paper-tei/smart_car/README.md

# 欢迎

本项目下的.md文件推荐用typora打开，文件已添加至仓库根目录处,文档正在编写中

更新日志：

1.完成了基本的文件分类索引 _2023.12.20

2.完成了平衡控制概述 _2023.12.22

3.完成了动量轮部分代码解析 _2024.1.2

4.规则更新,独轮组彻底成为历史,谢谢大家,江湖很大有缘再会 _2024.11.4

5.孩子们,我回来了 _2024.11.5
