paper-tei/smart_car/swjtu_-smart-car_23/README.md

# 欢迎

## 介绍
    西南交通大学 2023年 大学生智能汽车竞赛 独轮车组 “听党指挥，独轮不倒”队 开源项目

## 目录
1. 22_SWJTU_SmartCar-master 本人的22年老代码
2. hardware 独轮硬件迭代.开发软件:嘉立创专业版
3. **Seekfree_TC264_Opensource_Library 独轮软件工程**
4. TC264_Library-master 逐飞TC264例程
