paper-tei/smart_car/swjtu_-smart-car_23-master/3D/3D_PCB8_2023-03-08.SLDASM

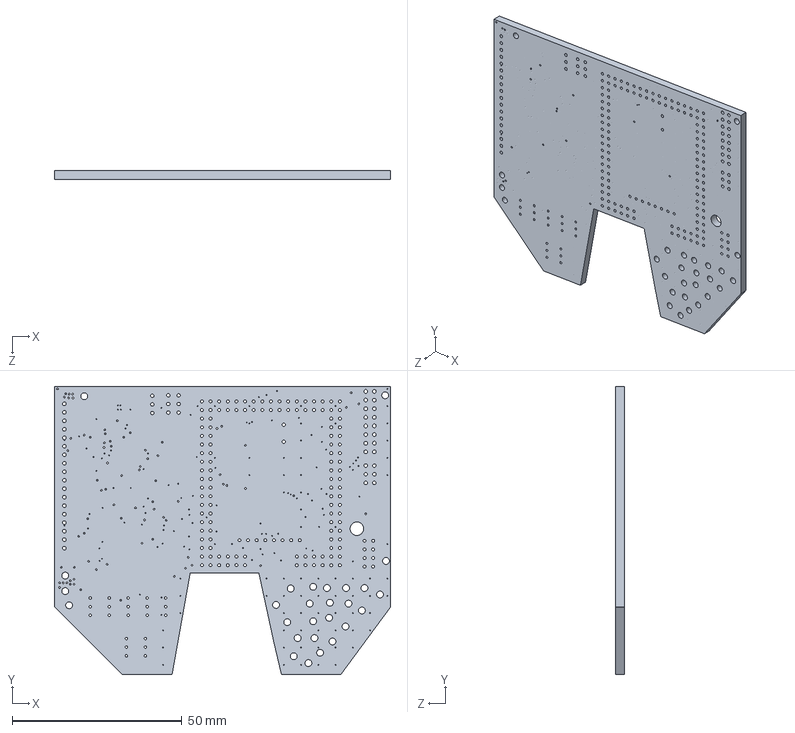
[picture p10: CAD file, 2023-09-15, last stored version]
swjtu_-smart-car_23-master/3D/3D_PCB8_2023-03-08.SLDASM
99.0 x 84.9 x 2.63 mm
