paper-tei/smart_car/swjtu_-smart-car_23-master/3D/云台/单云台/云台.SLDASM

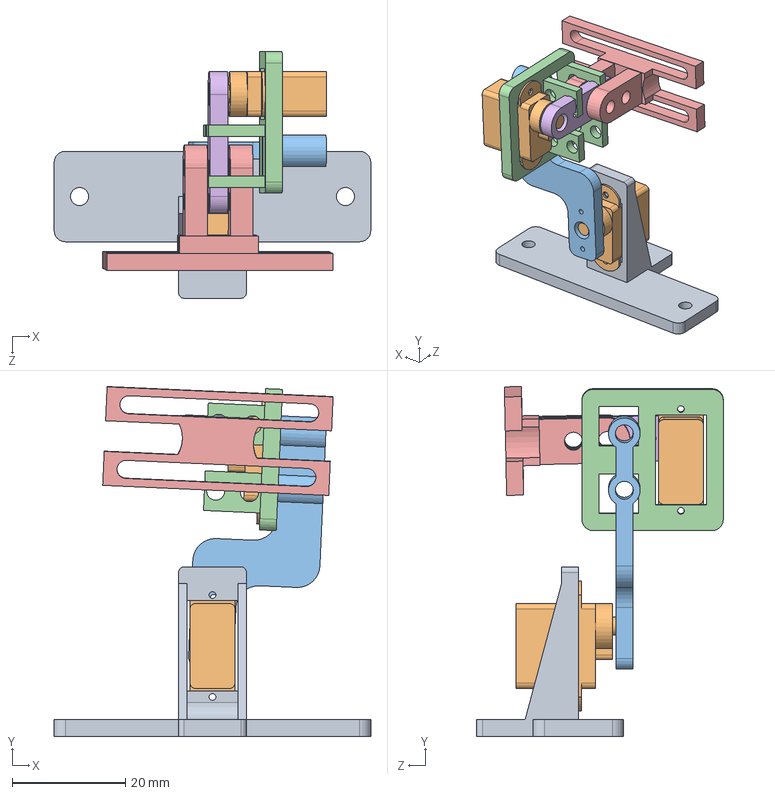
[picture p11: CAD file, 2023-09-15, last stored version]
swjtu_-smart-car_23-master/3D/云台/单云台/云台.SLDASM
56.0 x 61.9 x 43.6 mm
舵机1（1）
舵机 x 2
舵机1（2）
舵机2（1）
舵机2（2）
延长
