paper-tei/smart_car/swjtu_-smart-car_23-master/3D/云台/单云台/单云台.SLDASM

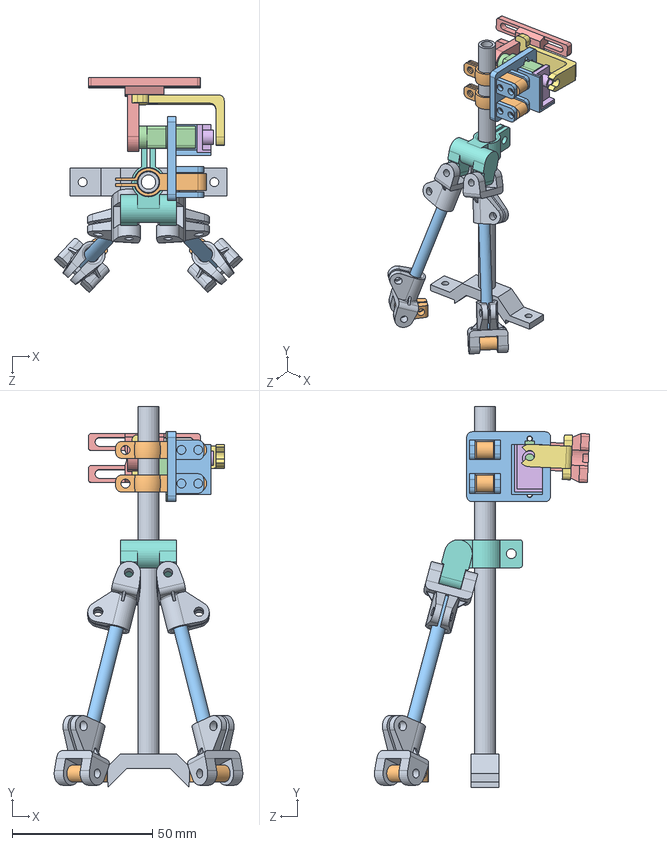
[picture p12: CAD file, 2023-09-15, last stored version]
swjtu_-smart-car_23-master/3D/云台/单云台/单云台.SLDASM
67.3 x 136.0 x 76.8 mm
摄像头底座支架1
舵机固定 x 2
舵机2（1）
舵机
云台摄像头支架
旋转轴
支架辅助
摄像头1
摄像头2(5mm) x 4
摄像头3 x 2
支杆 x 2
