paper-tei/smart_car/swjtu_-smart-car_23-master/3D/固定电池装配体2.SLDASM

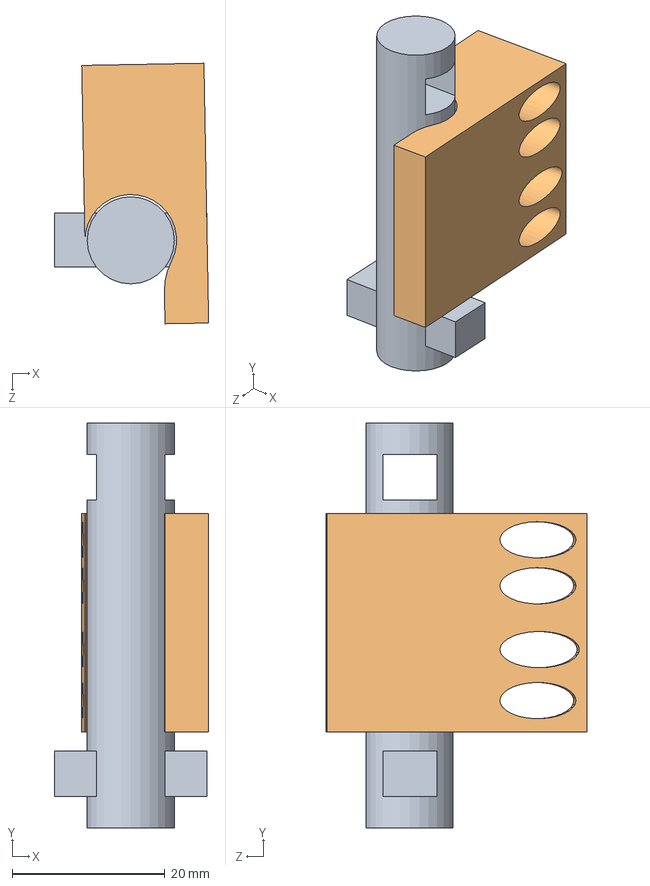
[picture p13: CAD file, 2023-09-15, last stored version]
swjtu_-smart-car_23-master/3D/固定电池装配体2.SLDASM
20.2 x 53.0 x 34.1 mm
柱子1
柱子挂件
