paper-tei/smart_car/swjtu_-smart-car_23-master/3D/云台/智能车摄像头/摄像头组合.SLDASM

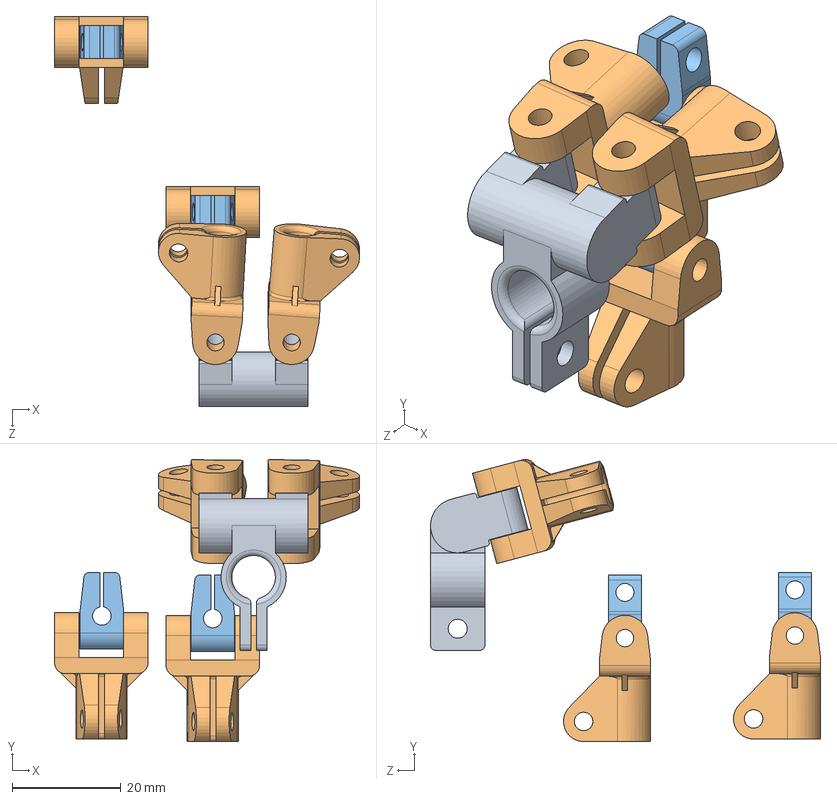
[picture p14: CAD file, 2023-09-15, last stored version]
swjtu_-smart-car_23-master/3D/云台/智能车摄像头/摄像头组合.SLDASM
56.0 x 51.8 x 71.6 mm
摄像头1
摄像头2(5mm) x 4
摄像头3 x 2
