paper-tei/smart_car/swjtu_-smart-car_23-master/3D/云台/单云台/舵机2（1）.SLDPRT

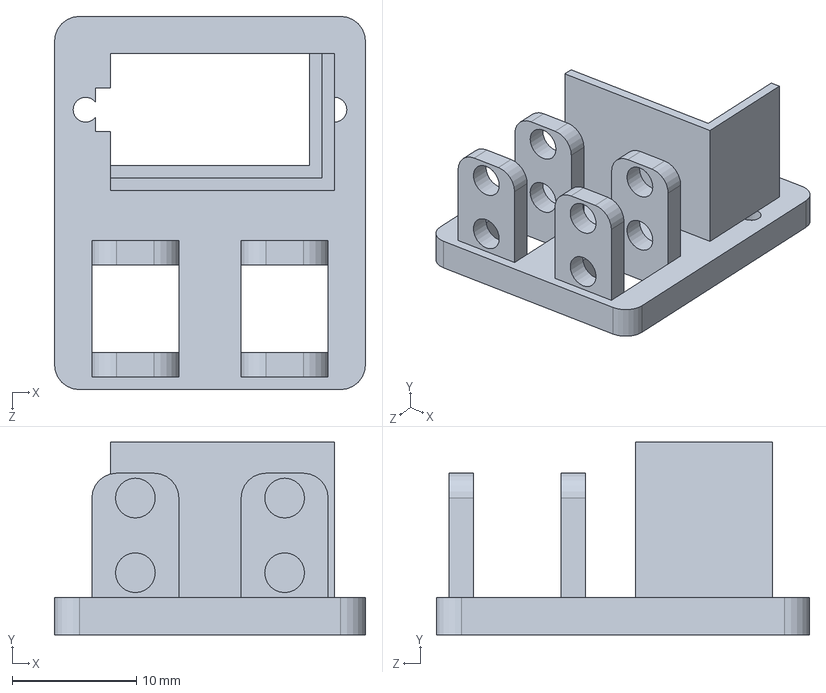
[picture p15: CAD file, 2023-09-15, last stored version]
swjtu_-smart-car_23-master/3D/云台/单云台/舵机2（1）.SLDPRT
25.0 x 15.5 x 30.0 mm
