paper-tei/smart_car/swjtu_-smart-car_23-master/3D/云台/智能车摄像头/摄像头2(8mm).SLDPRT

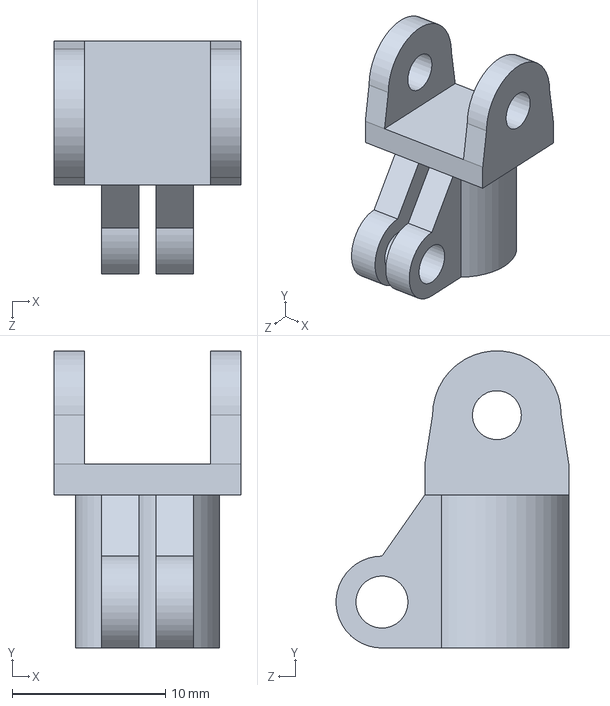
[picture p16: CAD file, 2023-09-15, last stored version]
swjtu_-smart-car_23-master/3D/云台/智能车摄像头/摄像头2(8mm).SLDPRT
12.2 x 19.4 x 15.2 mm
