paper-tei/smart_car/swjtu_-smart-car_23-master/3D/云台/智能车摄像头/摄像头3.SLDPRT

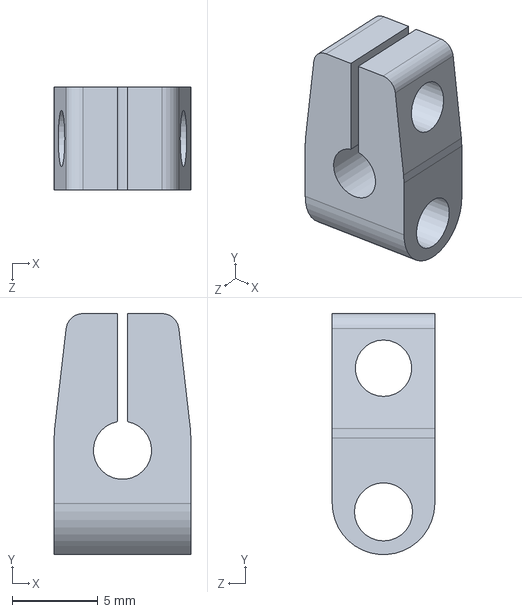
[picture p17: CAD file, 2023-09-15, last stored version]
swjtu_-smart-car_23-master/3D/云台/智能车摄像头/摄像头3.SLDPRT
8.00 x 14.1 x 6.00 mm
