paper-tei/smart_car/swjtu_-smart-car_23-master/3D/龙邱飞轮橡胶壳右-211119.STL

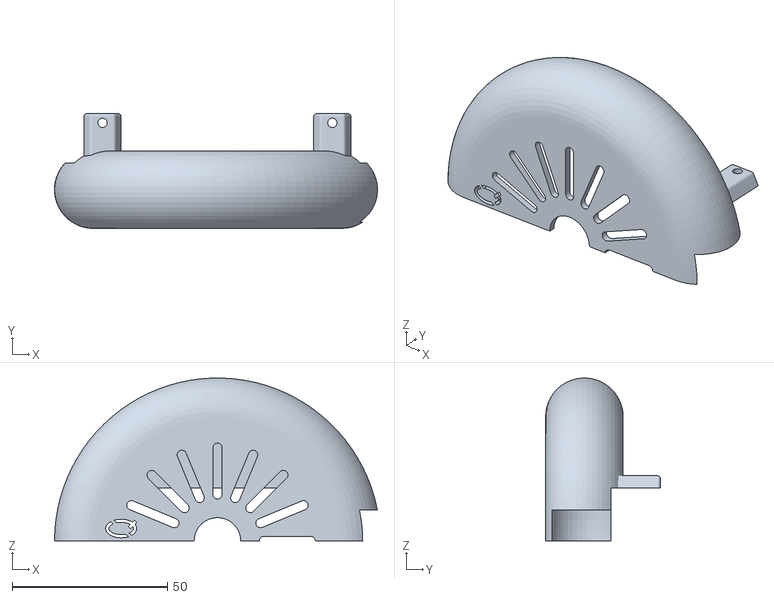
[picture p18: CAD file, 2023-09-15, last stored version]
swjtu_-smart-car_23-master/3D/龙邱飞轮橡胶壳右-211119.STL
104.0 x 37.0 x 52.4
