paper-tei/smart_car/swjtu_-smart-car_23-master/3D/PCB底座侧面1.SLDBLK.SLDPRT

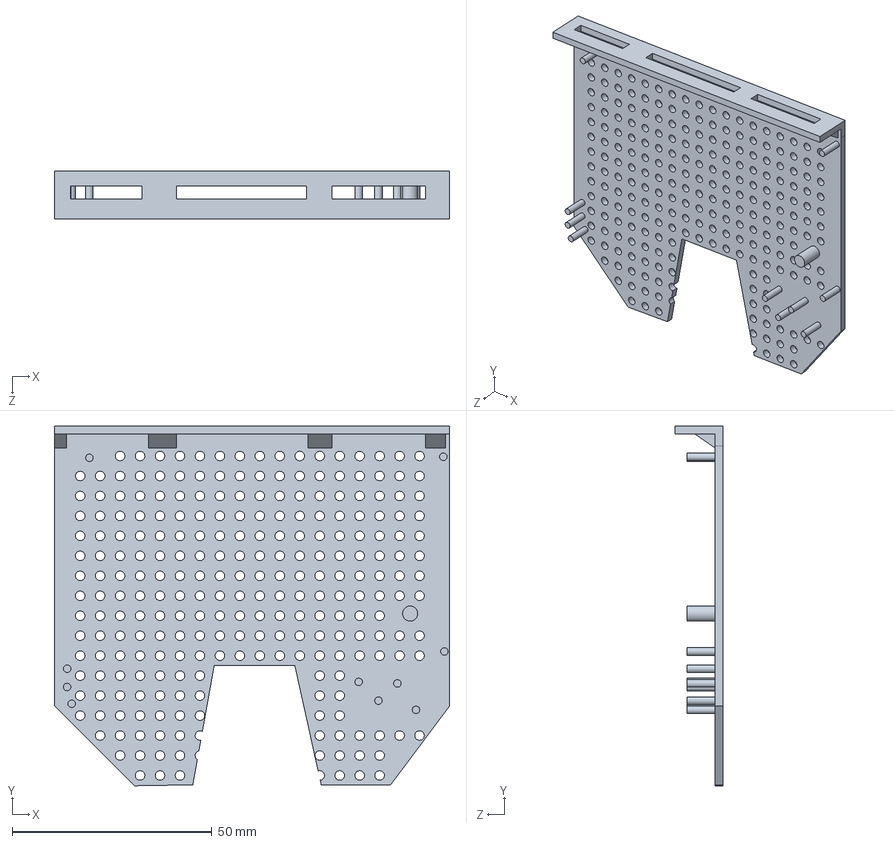
[picture p19: CAD file, 2023-09-15, last stored version]
swjtu_-smart-car_23-master/3D/PCB底座侧面1.SLDBLK.SLDPRT
98.9 x 90.1 x 12.0 mm
