paper-tei/smart_car/swjtu_-smart-car_23-master/3D/云台/智能车摄像头/摄像头2(+2).SLDPRT

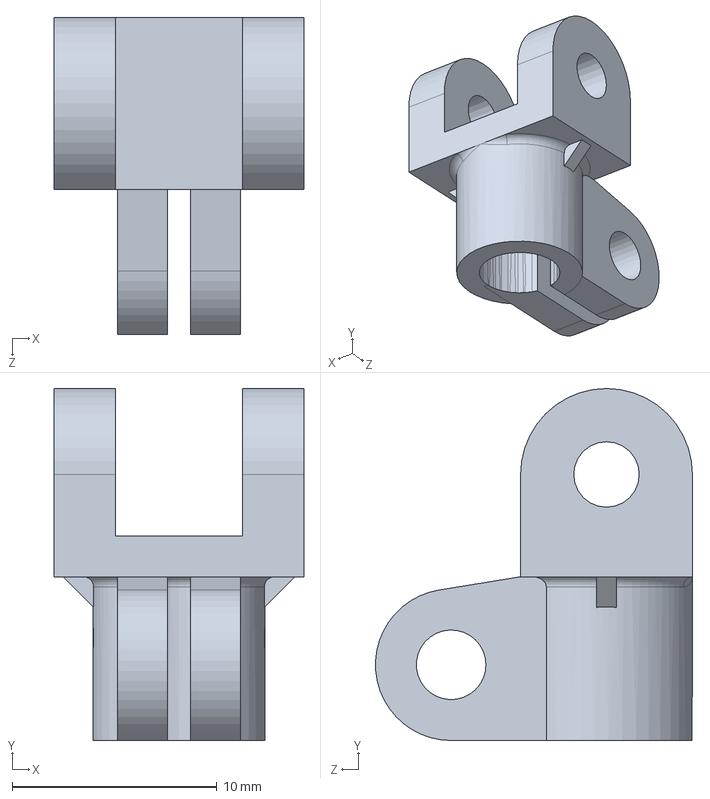
[picture p20: CAD file, 2023-09-15, last stored version]
swjtu_-smart-car_23-master/3D/云台/智能车摄像头/摄像头2(+2).SLDPRT
12.2 x 17.2 x 15.5 mm
