paper-tei/smart_car/swjtu_-smart-car_23-master/3D/云台/单云台/旋转轴.SLDPRT

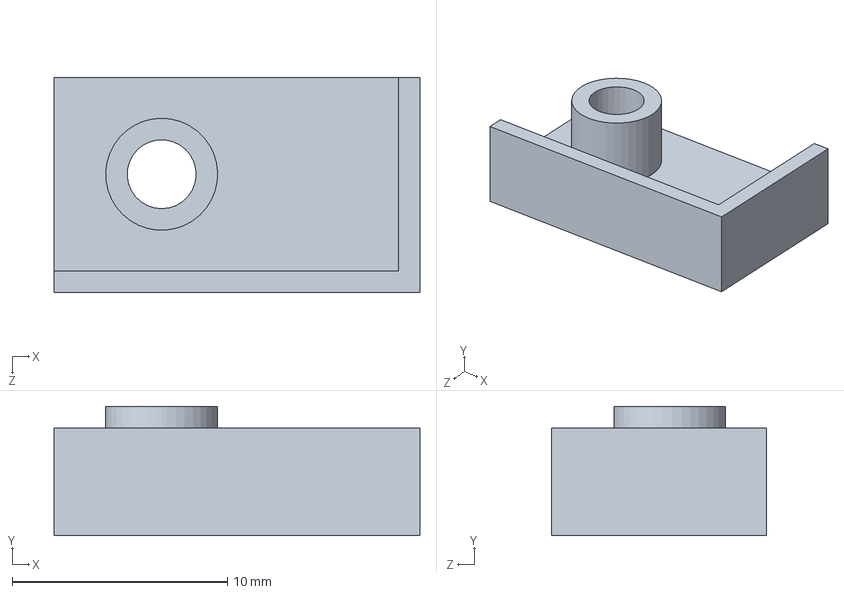
[picture p21: CAD file, 2023-09-15, last stored version]
swjtu_-smart-car_23-master/3D/云台/单云台/旋转轴.SLDPRT
17.0 x 6.00 x 10.0 mm
