paper-tei/smart_car/swjtu_-smart-car_23-master/3D/云台/智能车摄像头/摄像头1.SLDPRT

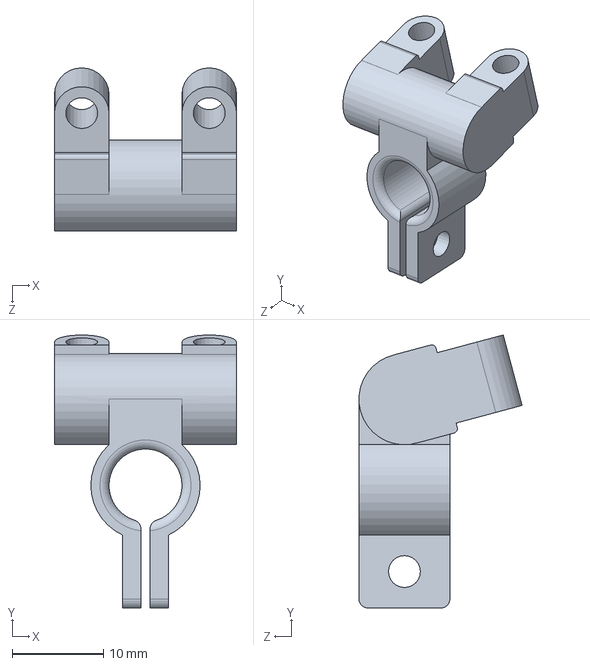
[picture p22: CAD file, 2023-09-15, last stored version]
swjtu_-smart-car_23-master/3D/云台/智能车摄像头/摄像头1.SLDPRT
20.0 x 30.0 x 17.9 mm
