paper-tei/smart_car/swjtu_-smart-car_23-master/3D/云台/单云台/支架辅助.SLDPRT

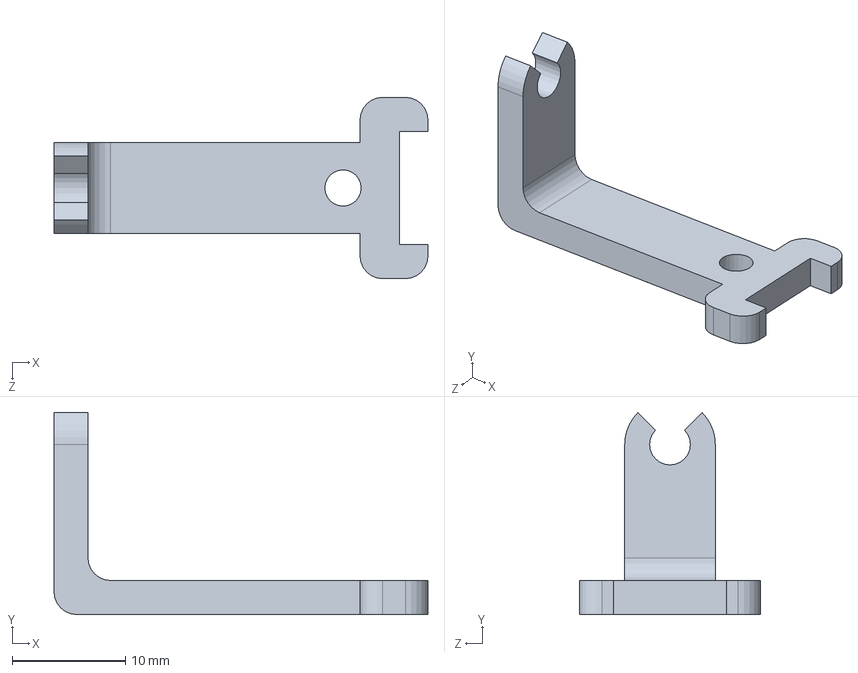
[picture p23: CAD file, 2023-09-15, last stored version]
swjtu_-smart-car_23-master/3D/云台/单云台/支架辅助.SLDPRT
33.0 x 17.8 x 16.0 mm
