paper-tei/smart_car/swjtu_-smart-car_23-master/3D/云台/智能车摄像头/摄像头2(5mm).SLDPRT

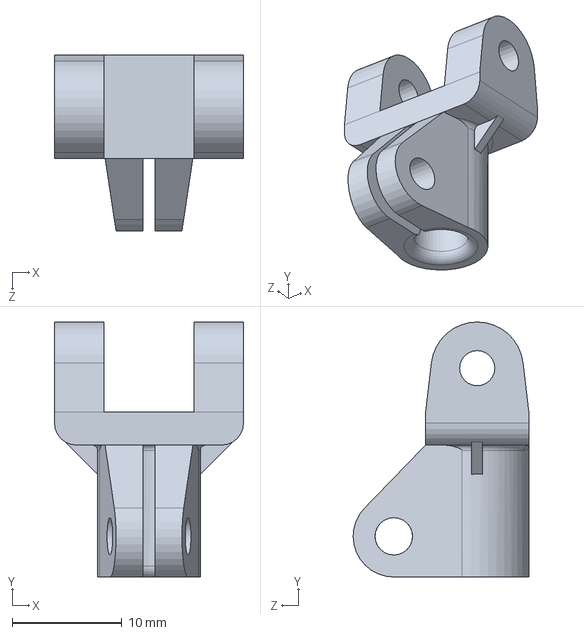
[picture p24: CAD file, 2023-09-15, last stored version]
swjtu_-smart-car_23-master/3D/云台/智能车摄像头/摄像头2(5mm).SLDPRT
17.2 x 23.2 x 16.0 mm
