paper-tei/smart_car/swjtu_-smart-car_23-master/3D/柱子挂件.SLDPRT

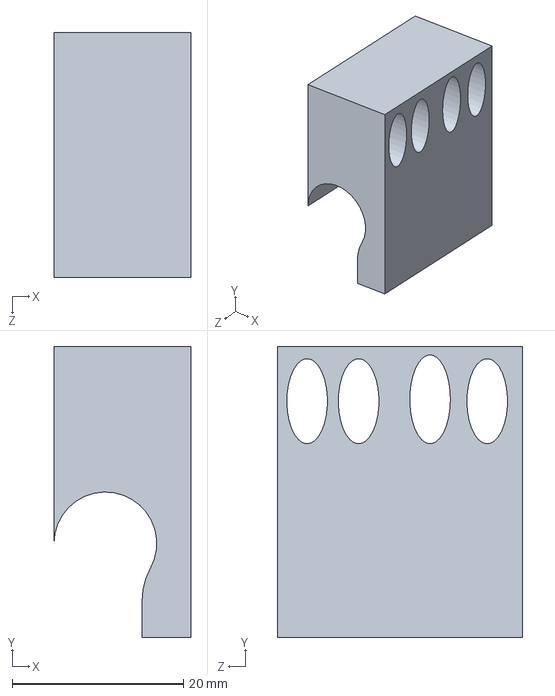
[picture p25: CAD file, 2023-09-15, last stored version]
swjtu_-smart-car_23-master/3D/柱子挂件.SLDPRT
16.0 x 34.0 x 28.6 mm
