paper-tei/smart_car/swjtu_-smart-car_23-master/3D/云台/单云台/云台摄像头支架.SLDPRT

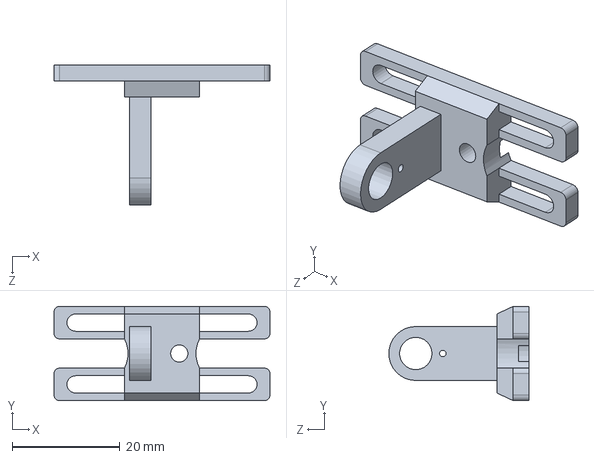
[picture p26: CAD file, 2023-09-15, last stored version]
swjtu_-smart-car_23-master/3D/云台/单云台/云台摄像头支架.SLDPRT
40.0 x 17.4 x 26.0 mm
