paper-tei/smart_car/swjtu_-smart-car_23-master/3D/固定电池装配体2 - 柱子挂件.STL

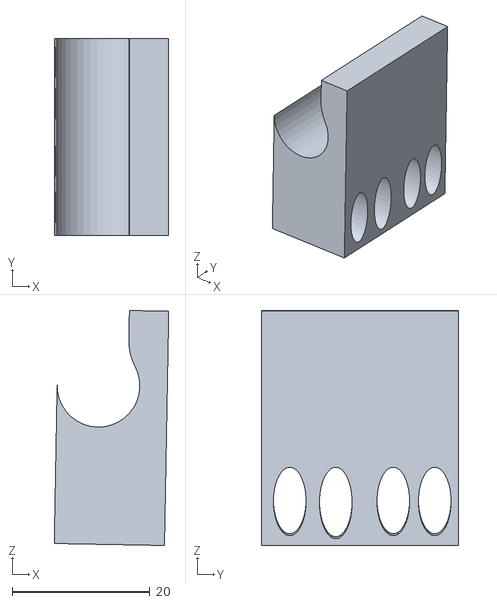
[picture p27: CAD file, 2023-09-15, last stored version]
swjtu_-smart-car_23-master/3D/固定电池装配体2 - 柱子挂件.STL
16.6 x 28.6 x 34.1
