paper-tei/smart_car/swjtu_-smart-car_23-master/3D/云台/单云台/舵机1（1）.SLDPRT

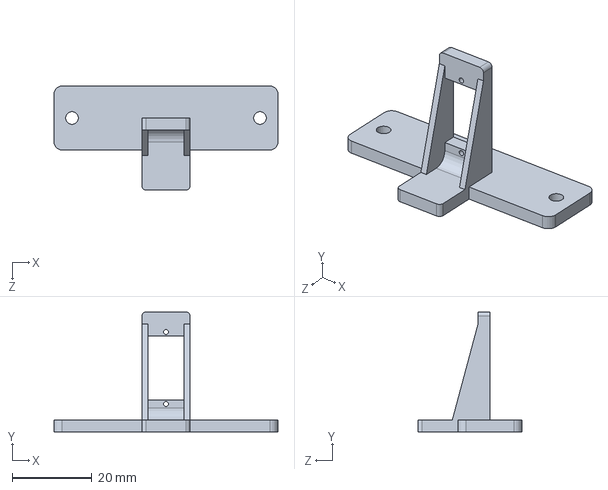
[picture p28: CAD file, 2023-09-15, last stored version]
swjtu_-smart-car_23-master/3D/云台/单云台/舵机1（1）.SLDPRT
56.0 x 30.0 x 26.0 mm
