paper-tei/smart_car/swjtu_-smart-car_23-master/3D/云台/智能车摄像头/摄像头2(+1).SLDPRT

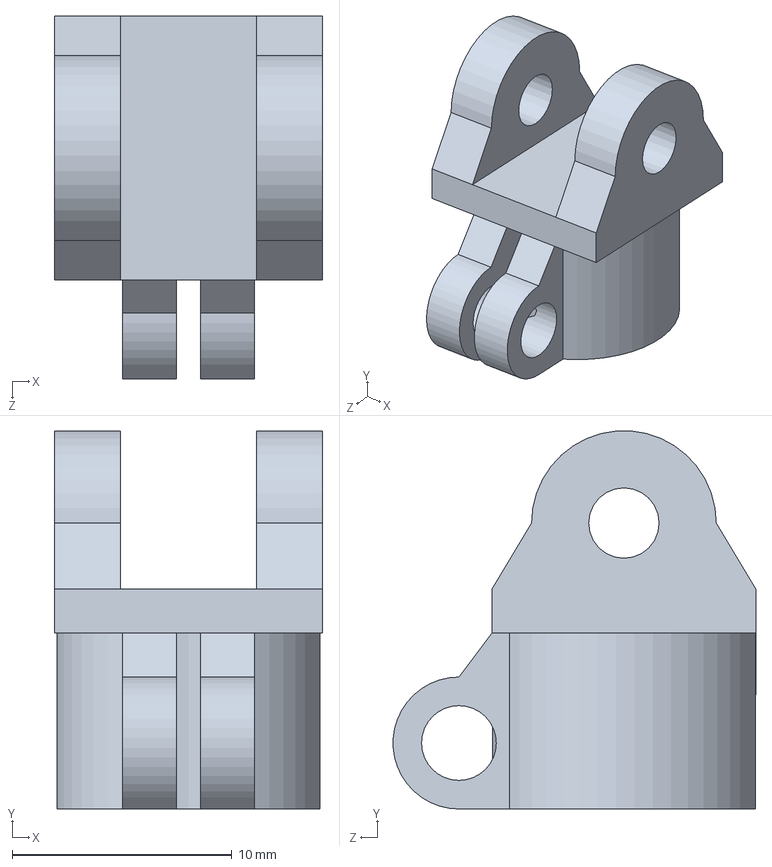
[picture p29: CAD file, 2023-09-15, last stored version]
swjtu_-smart-car_23-master/3D/云台/智能车摄像头/摄像头2(+1).SLDPRT
12.2 x 17.2 x 16.5 mm
