paper-tei/smart_car/swjtu_-smart-car_23-master/3D/云台/单云台/舵机2（2）.SLDPRT

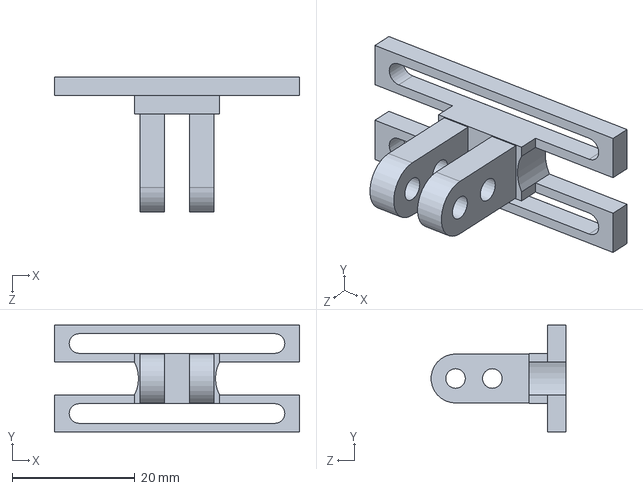
[picture p30: CAD file, 2023-09-15, last stored version]
swjtu_-smart-car_23-master/3D/云台/单云台/舵机2（2）.SLDPRT
40.0 x 17.4 x 22.0 mm
