paper-tei/smart_car/swjtu_-smart-car_23-master/3D/云台/智能车摄像头/支杆.SLDPRT

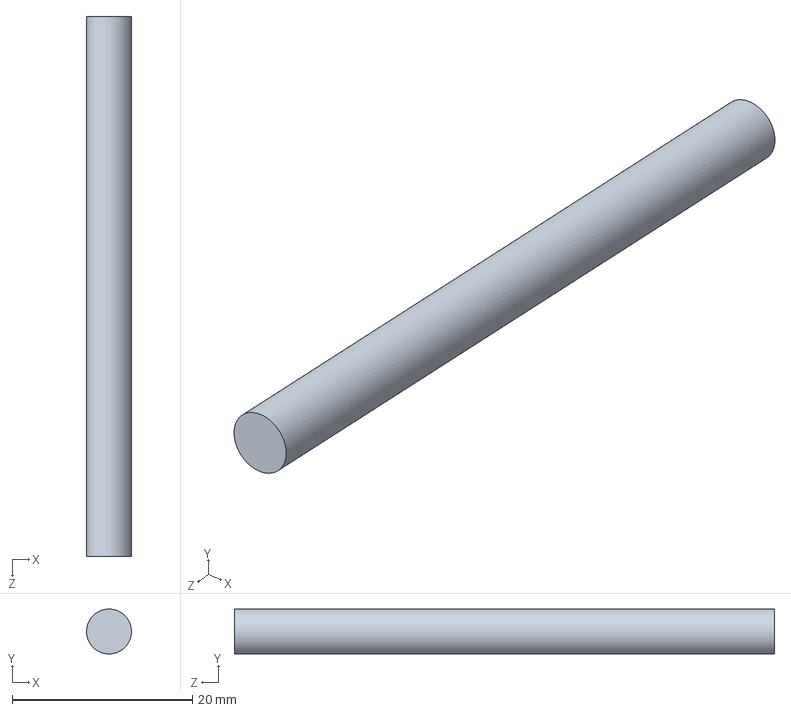
[picture p31: CAD file, 2023-09-15, last stored version]
swjtu_-smart-car_23-master/3D/云台/智能车摄像头/支杆.SLDPRT
5.00 x 5.00 x 60.0 mm
