paper-tei/smart_car/swjtu_-smart-car_23-master/3D/柱子1.SLDPRT

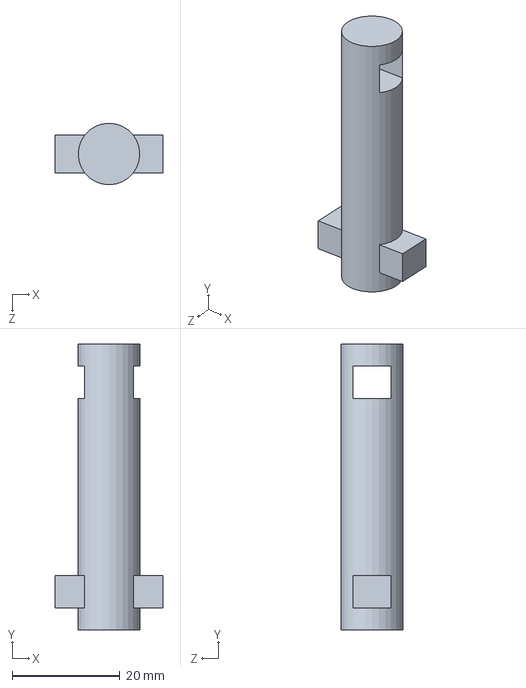
[picture p32: CAD file, 2023-09-15, last stored version]
swjtu_-smart-car_23-master/3D/柱子1.SLDPRT
20.0 x 53.0 x 11.4 mm
