paper-tei/smart_car/swjtu_-smart-car_23-master/3D/云台/单云台/舵机.SLDPRT

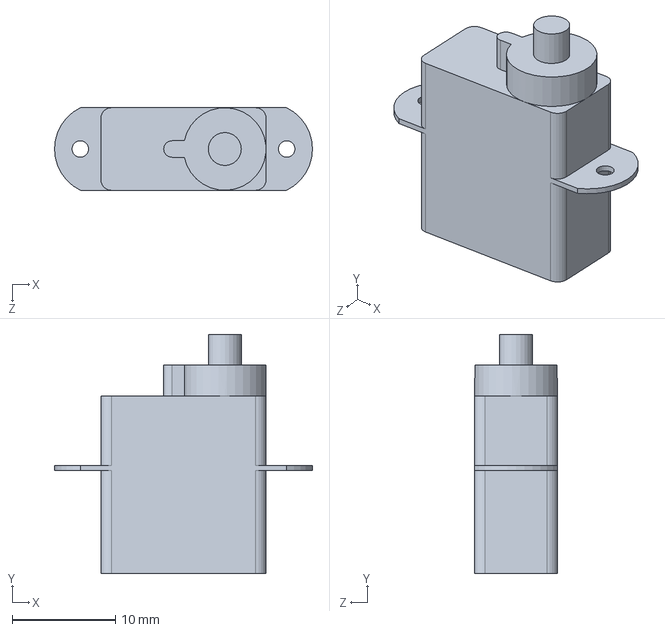
[picture p33: CAD file, 2023-09-15, last stored version]
swjtu_-smart-car_23-master/3D/云台/单云台/舵机.SLDPRT
25.0 x 23.2 x 8.00 mm
