paper-tei/smart_car/swjtu_-smart-car_23-master/3D/云台/单云台/舵机1（2）.SLDPRT

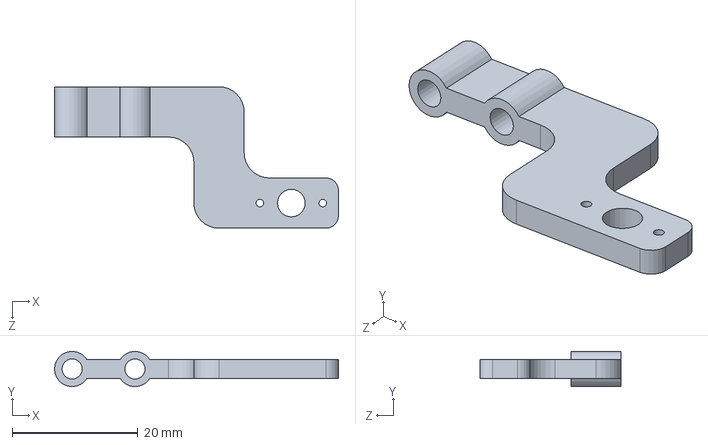
[picture p34: CAD file, 2023-09-15, last stored version]
swjtu_-smart-car_23-master/3D/云台/单云台/舵机1（2）.SLDPRT
45.2 x 5.59 x 22.5 mm
