paper-tei/smart_car/swjtu_-smart-car_23-master/3D/云台/单云台/舵机固定.SLDPRT

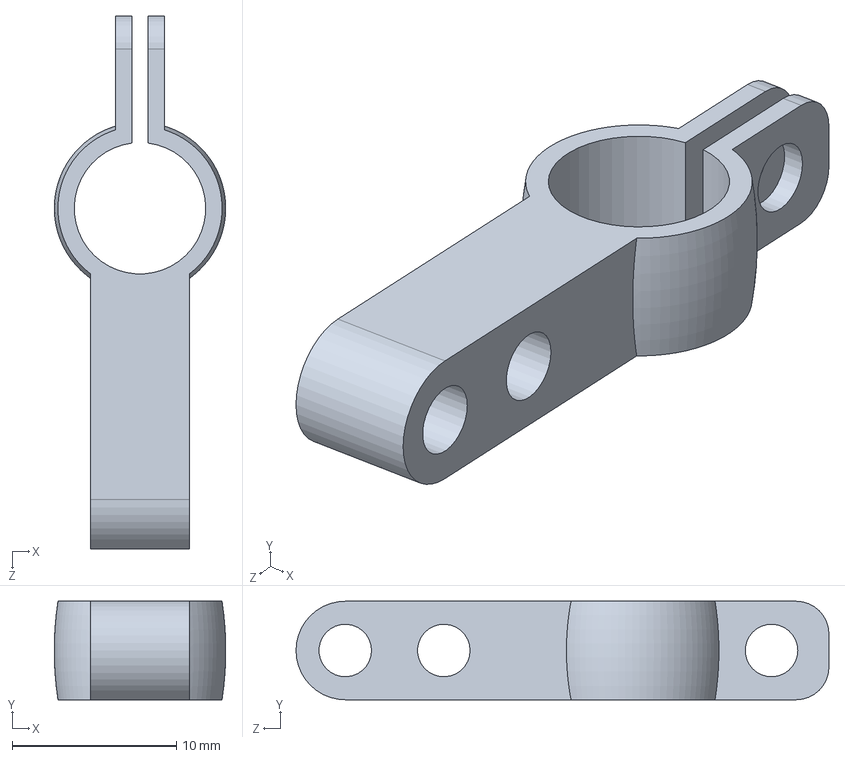
[picture p35: CAD file, 2023-09-15, last stored version]
swjtu_-smart-car_23-master/3D/云台/单云台/舵机固定.SLDPRT
10.4 x 6.00 x 32.5 mm
