paper-tei/smart_car/swjtu_-smart-car_23-master/3D/云台/单云台/延长.SLDPRT

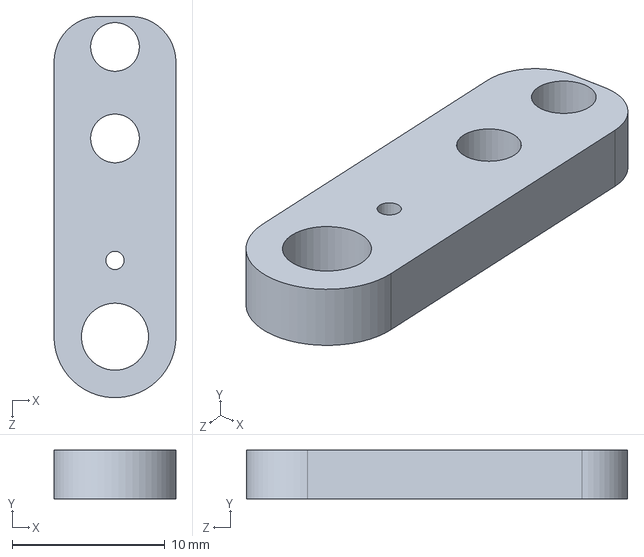
[picture p36: CAD file, 2023-09-15, last stored version]
swjtu_-smart-car_23-master/3D/云台/单云台/延长.SLDPRT
8.00 x 3.20 x 25.0 mm
