paper-tei/smart_car/(list of files, cad)

Other CAD files:
swjtu_-smart-car_23-master/3D/龙邱飞轮橡胶壳左-211119.STL
swjtu_-smart-car_23-master/3D/固定电池装配体2 - 柱子1.STL
swjtu_-smart-car_23-master/3D/PCB降压侧面垫板.SLDPRT
swjtu_-smart-car_23-master/3D/PCB底座侧面1.SLDBLK.STL
swjtu_-smart-car_23-master/3D/PCB降压侧面垫板.STL
swjtu_-smart-car_23-master/3D/柱子1.STL
swjtu_-smart-car_23-master/3D/柱子挂件.STL
