paper-tei/smart_car/(list of files, drawings)

Other design files:
swjtu_-smart-car_23/hardware/一体板.epro
