paper-tei/smart_car/swjtu_-smart-car_23/22_SWJTU_SmartCar-master/CODE/motor.h

/*
 * motor.h
 *
 *  Created on: 2022Äê1ÔÂ6ÈÕ
 *      Author: paper
 */

#ifndef CODE_MOTOR_H_
#define CODE_MOTOR_H_
#include "headfile.h"
void Motor_control_right(int32 speed);
void Motor_control_left(int32 speed);
void control_speed(void);
extern unsigned char go;


#endif /* CODE_MOTOR_H_ */
