paper-tei/smart_car/swjtu_-smart-car_23/Seekfree_TC264_Opensource_Library/Seekfree_TC264_Opensource_Library/user/cpu0_main.h

/**
 * \file Cpu0_Main.h
 * \brief System initialization and main program implementation.
 *
 * \version iLLD_Demos_1_0_1_11_0
 * \copyright Copyright (c) 2014 Infineon Technologies AG. All rights reserved.
 *
 *
 *                                 IMPORTANT NOTICE
 *
 *
 * Use of this file is subject to the terms of use agreed between (i) you or
 * the company in which ordinary course of business you are acting and (ii)
 * Infineon Technologies AG or its licensees. If and as long as no such
 * terms of use are agreed, use of this file is subject to following:


 * Boost Software License - Version 1.0 - August 17th, 2003

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
 * The copyright notices in the Software and this entire statement, including
 * the above license grant, this restriction and the following disclaimer, must
 * be included in all copies of the Software, in whole or in part, and all
 * derivative works of the Software, unless such copies or derivative works are
 * solely in the form of machine-executable object code generated by a source
 * language processor.

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
 *
 * \defgroup IfxLld_Demo_STMDemo_SrcDoc Source code documentation
 * \ingroup IfxLld_Demo_STMDemo
 *
 */

#ifndef CPU0_MAIN_H
#define CPU0_MAIN_H

 /******************************************************************************/
 /*----------------------------------Includes----------------------------------*/
 /******************************************************************************/


#include "Cpu/Std/Ifx_Types.h"
/******************************************************************************/
/*-----------------------------------Macros-----------------------------------*/
/******************************************************************************/

/******************************************************************************/
/*------------------------------Type Definitions------------------------------*/
/******************************************************************************/

typedef struct {
    float32 sysFreq;                /**< \brief Actual SPB frequency */
    float32 cpuFreq;                /**< \brief Actual CPU frequency */
    float32 pllFreq;                /**< \brief Actual PLL frequency */
    float32 stmFreq;                /**< \brief Actual STM frequency */
} AppInfo;

/** \brief Application information */
typedef struct {
    AppInfo info;                               /**< \brief Info object */
} App_Cpu0;

/******************************************************************************/
/*------------------------------Global variables------------------------------*/
/******************************************************************************/

IFX_EXTERN App_Cpu0 g_AppCpu0;

#endif
