paper-tei/smart_car/swjtu_-smart-car_23/22_SWJTU_SmartCar-master/CODE/In_out_bound.h

/*
 * In_out_bound.h
 *
 *  Created on: 2022Äê2ÔÂ18ÈÕ
 *      Author: paper
 */

#ifndef CODE_IN_OUT_BOUND_H_
#define CODE_IN_OUT_BOUND_H_
#include "headfile.h"
void scratch_line(void);
extern int scratch_cnt,  in_home_hang ;
extern uint8 hall_detection_flag ;
extern uint8 Zebra_flag;
#endif /* CODE_IN_OUT_BOUND_H_ */
