paper-tei/smart_car/swjtu_-smart-car_23/22_SWJTU_SmartCar-master/CODE/cross.h

/*
 * cross.h
 *
 *  Created on: 2022Äê2ÔÂ26ÈÕ
 *      Author: paper
 */

#ifndef CODE_CROSS_H_
#define CODE_CROSS_H_
#include "headfile.h"
void cross_find(void);
void cross_ru(void);
extern uint8 cross_flag ;
#endif /* CODE_CROSS_H_ */
