paper-tei/smart_car/swjtu_-smart-car_23/22_SWJTU_SmartCar-master/CODE/fuzzy.h

/*
 * fuzzy.h
 *
 *  Created on: 2021Äê7ÔÂ10ÈÕ
 *      Author: 13179
 */

#ifndef CODE_FUZZY_H_
#define CODE_FUZZY_H_
#include "headfile.h"

extern float Fuzzy_P(float E,float EC);
extern float Fuzzy_D(float E,float EC);

#endif /* CODE_FUZZY_H_ */
