paper-tei/smart_car/swjtu_-smart-car_23/22_SWJTU_SmartCar-master/CODE/home.h

/*
 * home.h
 *
 *      Author: paper
 */

#ifndef CODE_HOME_H_
#define CODE_HOME_H_
#include "headfile.h"
extern void chu_ku(void);
extern void ru_ku(void);
extern float range_chu_count;
extern unsigned char Out_Home_flag ;
extern unsigned char In_Home_flag ;
extern unsigned char icm_Home_flag;
extern float icm_home ;
#endif 
