paper-tei/smart_car/swjtu_-smart-car_23/22_SWJTU_SmartCar-master/CODE/icm.h

/*
 * ICM.h
 *
 *  Created on: 2022Äê2ÔÂ18ÈÕ
 *      Author: paper
 */

#ifndef CODE_ICM_H_
#define CODE_ICM_H_
#include "headfile.h"
void icm_int(void);
void D2M_Control(void);
extern float er_speed;
extern float temp_angle;
#endif /* CODE_ICM_H_ */
