paper-tei/smart_car/(commit log)

2023-09-15 初次提交，代码未整理，文件夹名为Seekfree_TC264_Opensource_Library
    [3D_PCB8_2023-03-08.SLDASM, PCB底座侧面1.SLDBLK.SLDPRT, PCB底座侧面1.SLDBLK.STL, PCB降压侧面垫板.SLDPRT, PCB降压侧面垫板.STL, 一体板.epro, 云台.SLDASM, 云台摄像头支架.SLDPRT]
2023-12-10 删除大部分无用代码，为文档做准备
    [3D_PCB8_2023-03-08.SLDASM, PCB底座侧面1.SLDBLK.SLDPRT, PCB底座侧面1.SLDBLK.STL, PCB降压侧面垫板.SLDPRT, PCB降压侧面垫板.STL, 一体板.epro, 云台.SLDASM, 云台摄像头支架.SLDPRT]
2023-12-10 删除重复的文件夹
2023-12-20 完成了基本的文件分类索引
2023-12-21 完成了平衡控制概述
2023-12-21 在readme中加入了其他md文件的超链接
2023-12-21 修改了错误的图片地址
2024-01-02 完成了动量轮部分代码解析
2024-03-06 删除了无用的示例，完善了新版本ads导入
    [例程功能说明.xlsx]
