paper-tei/smart_car/(notices)

Notices in the files:
swjtu_-smart-car_23/Seekfree_TC264_Opensource_Library/Seekfree_TC264_Opensource_Library/user/isr_config.h:
Copyright (c) 2022 SEEKFREE Öð·É¿Æ¼¼
